HexabitzPlatform/H41R6x-Hardware/README.md

# H41R6x-Hardware
Hexabitz STM32F4 LQFP100 Module Hardware Design
