HexabitzPlatform/H41R6x-Hardware/H41R60/Released/BOM/H41R60.xlsx

Qty | Comment | Designator | Description | MFN | MPN | OCTOPART_URL | Qty
8 | 100nF | C3, C4, C5, C6, C7, C8, C10, C11 | CAP CER 10% X7R 0603 | KEMET | C0603C104K8RACTU | https://octopart.com/c0603c104k8ractu-kemet-145075?r=sp&s=9bS9ASSwSEqMCE9KBEQZ0g
1 | 1.00uF | C2 | CAP CER 1UF 16V X7R 0805 | Yageo | CC0805KKX7R7BB105 | https://octopart.com/cc0805kkx7r7bb105-yageo-8376555?r=sp&s=YKl1wwtkROau_X5nniH2ig
1 | 4.7uF | C9 | CAP CER 4.7UF 25V X6S 0805 | Murata | GRM21BC81E475KA12L | https://octopart.com/grm21bc81e475ka12l-murata-10331911?r=sp&s=RY3qZSD8T6mG6TC9CHI5qQ
2 | 2.2uF | C12, C13 | CAP CER 2.2UF 10% X7R 0603 | TDK | C1608X5R1C225K080AB | https://octopart.com/c1608x5r1c225k080ab-tdk-26013481?r=sp&s=zh0P7eqWSJSPxGSwstsLZg
1 | 10nF | C1 | CAP CER 10% X7R 0603 | KEMET | C0603C103K5RACTU | https://octopart.com/c0603c103k5ractu-kemet-133094?r=sp&s=R_iPBxLnSmGqhkU2rIMFpg
1 | VLMS1300-GS08 | D1 | Red 0603 130ｰ Clear 54 mcd 2 V Surface Mount ChipLED ; | Vishay | VLMS1300-GS08 | https://octopart.com/vlms1300-gs08-vishay-21709201?r=sp&s=_gcP4_q8T1SC6PJQPTQ9yA
1 | FB-TDK_MMZ1608Y300B | FB1 | Ferrite Beads Multi-Layer 30Ohm 25% 100MHz 1.5A 50mOhm DCR 0603 | TDK | MMZ1608Y300B | https://octopart.com/mmz1608y300b-tdk-368280?r=sp&s=cd9_2ZEqQ9q9UNBuQgHAiA
1 | 270.0R | R1 | Thick Film Resistors - SMD 0603 | Yageo | RC0603FR-07270RL | https://octopart.com/erj-3geyj271v-panasonic-55560546
1 | 0.0R | R2 | Thick Film Resistors - SMD 0603 | Yageo | RC0603JR-070RL | https://octopart.com/crcw06030000z0eahp-vishay-44320230
1 | 10.0K | R3 | Thick Film Resistors - SMD 0603 | Yageo | RC0603JR-0710KL | https://octopart.com/crcw060310k0jneb-vishay+dale-46603268
1 | STM32F413VHT6 | U1 | ARM Cortex-M4 STM32F4 Microcontroller IC 32-Bit 100MHz 1.5MB (1.5M x 8) FLASH 100-LQFP (14x14) | STMicroelectronics | STM32F413VHT6 | https://octopart.com/stm32f413vht6-stmicroelectronics-75832293?r=sp&s=_e4TXIFmR5mlyuiVVXP48A
1 | XTALL_CSTCE8M00G52 | X1 | MURATA CSTCE8M00G52-R0 RESONATOR, SMD, 8MHZ ; | Murata | CSTCE8M00G52Z-R0 | https://octopart.com/cstce8m00g52z-r0-murata-17755941?r=sp&s=JDnNJnrHQhyS8Zk4ofFWXw
