HexabitzPlatform/H41R6x-Hardware/H41R60/Documentation/H41R60-13 Schematics.pdf

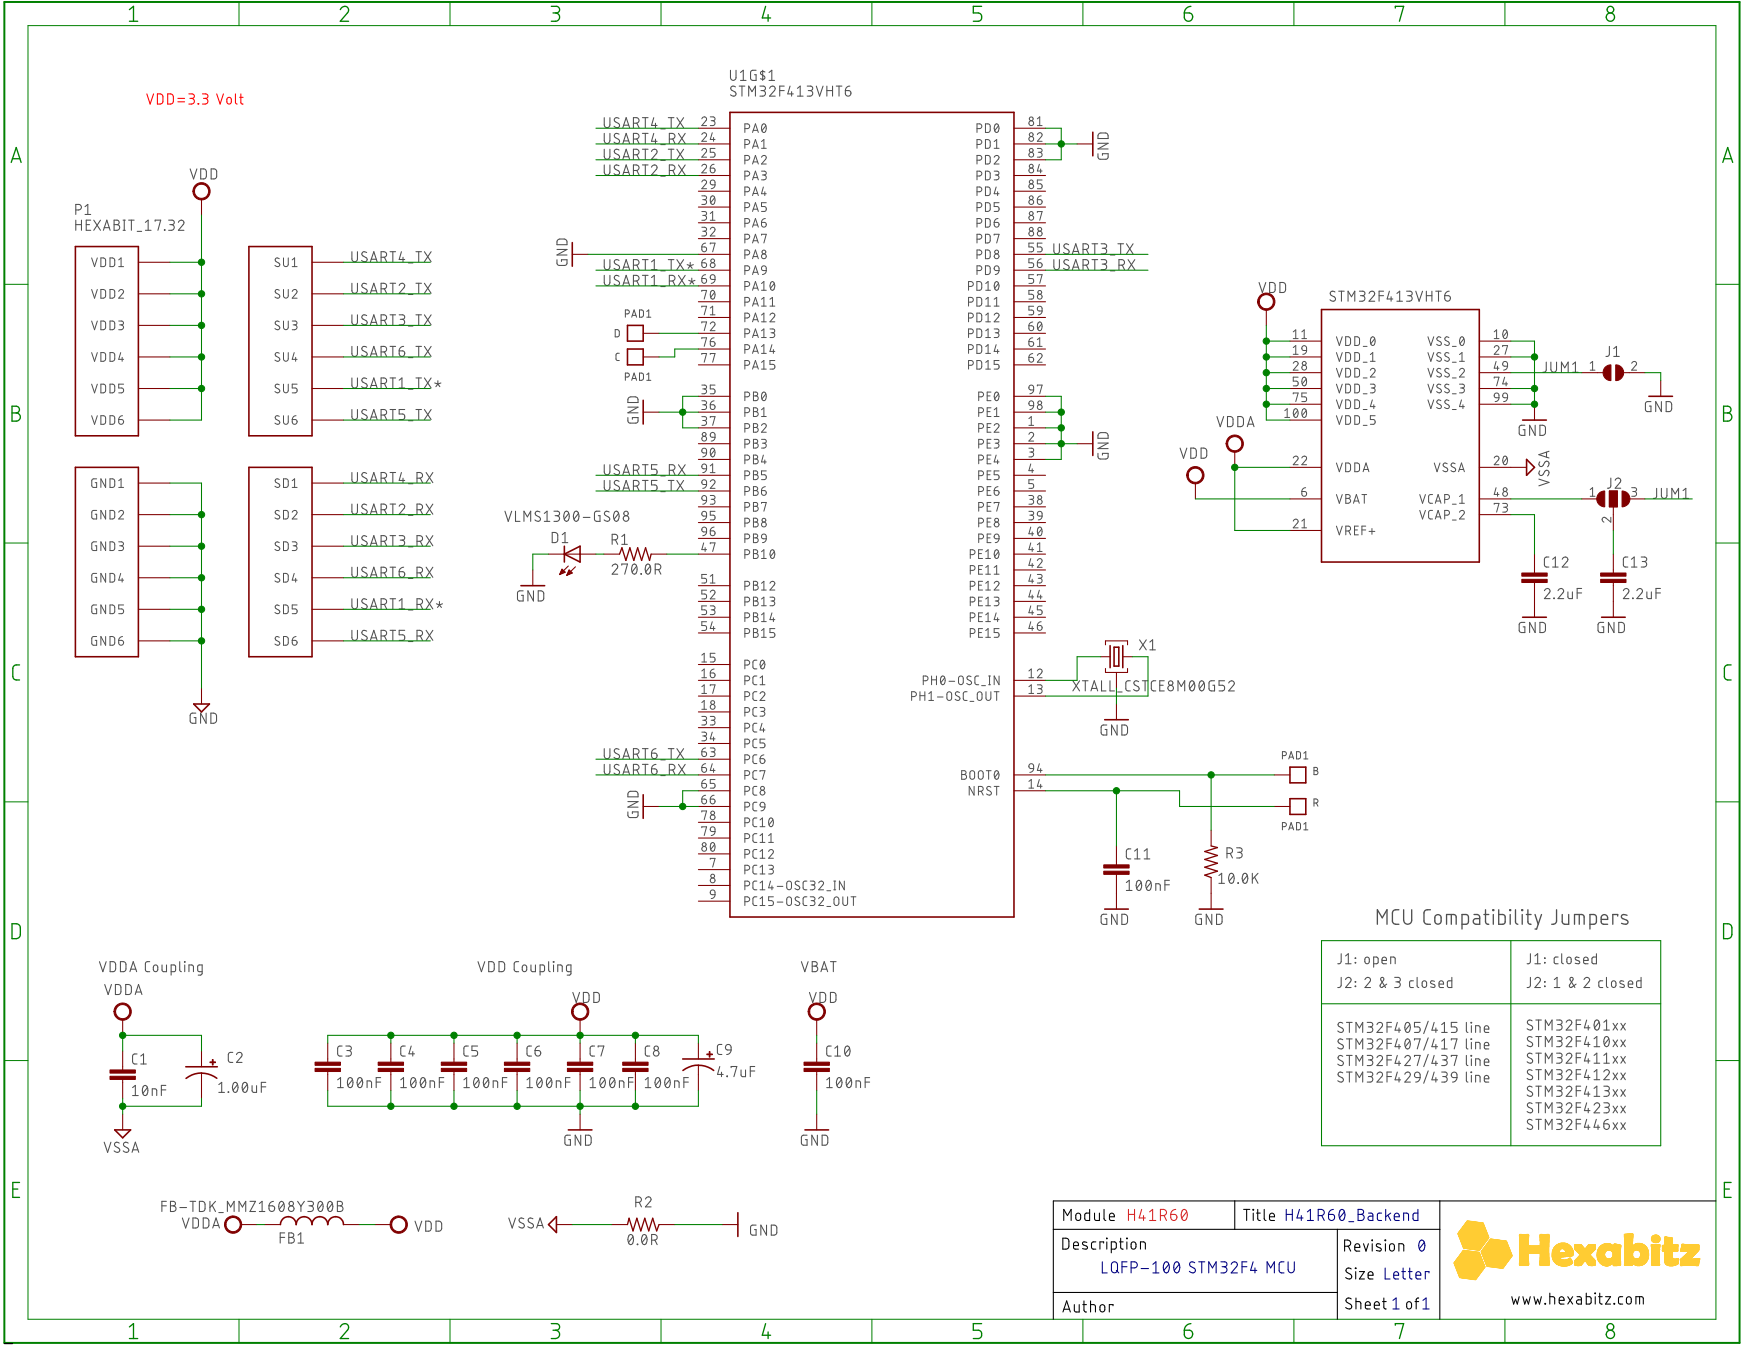
[picture p1: page 1]
