HexabitzPlatform/H41R6x-Hardware/H41R60/Design/H41R60.brd

## EAGLE design H41R60/Design/H41R60.brd (2019-05-23)

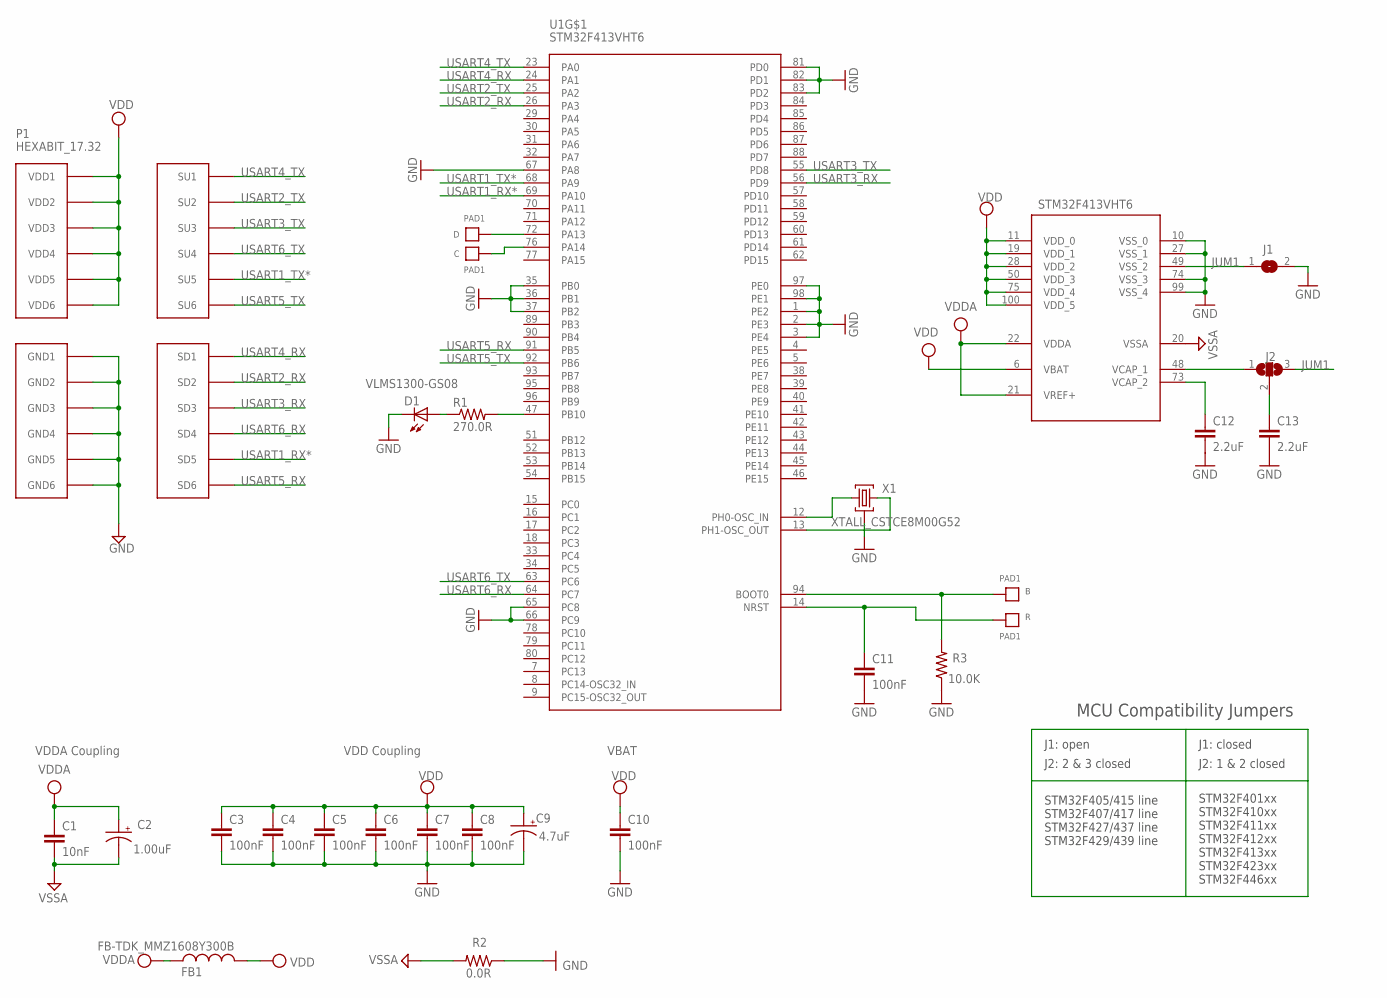
[picture p2: schematic H41R60.sch]

Parts:
B: PAD1
C: PAD1
C1: 10nF; C-0603; TOLERANCE 10%; VOLTAGE_RATING 50V; MPN C0603C103K5RACTU
C2: 1.00uF; C-0805-POL; TOLERANCE 10%; VOLTAGE_RATING 16V; MPN CC0805KKX7R7BB105
C3, C4, C5, C6, C8, C11: 100nF; C-0603; TOLERANCE 10%; VOLTAGE_RATING 10V; MPN C0603C104K8RACTU
C7: 100nF; C-0603; TOLERANCE 10%; VOLTAGE_RATING 10; MPN C0603C104K8RACTU
C9: 4.7uF; C-0805-POL; TOLERANCE 10%; VOLTAGE_RATING 25V; MPN GRM21BC81E475KA12L
C10: 100nF; C-0603; TOLERANCE 10V; VOLTAGE_RATING 10%; MPN C0603C104K8RACTU
C12, C13: 2.2uF; C-0603; TOLERANCE 16V; VOLTAGE_RATING 20%; MPN C1608X5R1C225K080AB
D: PAD1
D1: VLMS1300-GS08; MPN VLMS1300-GS08
FB1: FB-TDK_MMZ1608Y300B; MPN MMZ1608Y300B
J1: SJ
J2: SJ2W; SJ_2
P1: HEXABIT_17.32
R: PAD1
R1: 270.0R; R-0603; TOLERANCE 1%; MPN RC0603FR-07270RL
R2: 0.0R; R-0603; MPN RC0603JR-070RL
R3: 10.0K; R-0603; TOLERANCE 5%; MPN RC0603JR-0710KL
U1: STM32F413VHT6; LQFP-100
X1: XTALL_CSTCE8M00G52

Connections:
B1: B.P$1, B.P$2, R3.2, U1.94 (BOOT0)
GND: C3.2, C4.2, C5.2, C6.2, C7.2, C8.2, C9.2 (-), C10.2, C11.2, C12.2, C13.2, D1.C, J1.2, P1.PAD_PD7 (GND1), P1.PAD_PD8 (GND2), P1.PAD_PD9 (GND3), P1.PAD_PD10 (GND4), P1.PAD_PD11 (GND5), P1.PAD_PD12 (GND6), R2.1, R3.1, U1.1 (PE2), U1.2 (PE3), U1.3 (PE4), U1.10 (VSS_0), U1.27 (VSS_1), U1.35 (PB0), U1.36 (PB1), U1.37 (PB2), U1.65 (PC8), U1.66 (PC9), U1.67 (PA8), U1.74 (VSS_3), U1.81 (PD0), U1.82 (PD1), U1.83 (PD2), U1.97 (PE0), U1.98 (PE1), U1.99 (VSS_4), X1.P$2 (2)
JUM1: J1.1, J2.3, U1.49 (VSS_2)
unnamed: D.P$1, D.P$2, U1.72 (PA13)
unnamed: C.P$1, C.P$2, U1.76 (PA14)
unnamed: U1.12 (PH0-OSC_IN), X1.P$1 (1)
unnamed: U1.13 (PH1-OSC_OUT), X1.P$3 (3)
unnamed: C12.1, U1.73 (VCAP_2)
unnamed: C13.1, J2.2
unnamed: R1.2, U1.47 (PB10)
unnamed: D1.A, R1.1
unnamed: J2.1, U1.48 (VCAP_1)
R1: C11.1, R.P$1, R.P$2, U1.14 (NRST)
USART1_RX*: P1.PAD_PD5 (SD5), U1.69 (PA10)
USART1_TX*: P1.PAD_PU5 (SU5), U1.68 (PA9)
USART2_RX: P1.PAD_PD2 (SD2), U1.26 (PA3)
USART2_TX: P1.PAD_PU2 (SU2), U1.25 (PA2)
USART3_RX: P1.PAD_PD3 (SD3), U1.56 (PD9)
USART3_TX: P1.PAD_PU3 (SU3), U1.55 (PD8)
USART4_RX: P1.PAD_PD1 (SD1), U1.24 (PA1)
USART4_TX: P1.PAD_PU1 (SU1), U1.23 (PA0)
USART5_RX: P1.PAD_PD6 (SD6), U1.91 (PB5)
USART5_TX: P1.PAD_PU6 (SU6), U1.92 (PB6)
USART6_RX: P1.PAD_PD4 (SD4), U1.64 (PC7)
USART6_TX: P1.PAD_PU4 (SU4), U1.63 (PC6)
VDD: C3.1, C4.1, C5.1, C6.1, C7.1, C8.1, C9.1 (+), C10.1, FB1.2, P1.PAD_PU7 (VDD1), P1.PAD_PU8 (VDD2), P1.PAD_PU9 (VDD3), P1.PAD_PU10 (VDD4), P1.PAD_PU11 (VDD5), P1.PAD_PU12 (VDD6), U1.6 (VBAT), U1.11 (VDD_0), U1.19 (VDD_1), U1.28 (VDD_2), U1.50 (VDD_3), U1.75 (VDD_4), U1.100 (VDD_5)
VDDA: C1.1, C2.1 (+), FB1.1, U1.21 (VREF+), U1.22 (VDDA)
VSSA: C1.2, C2.2 (-), R2.2, U1.20 (VSSA)

Notes on the sheet:
VDDA Coupling
VDD Coupling
VBAT
STM32F405/415 line STM32F407/417 line STM32F427/437 line STM32F429/439 line
STM32F401xx STM32F410xx STM32F411xx STM32F412xx STM32F413xx STM32F423xx STM32F446xx
J1: open
J2: 2 & 3 closed
J1: closed
J2: 1 & 2 closed
MCU Compatibility Jumpers
STM32F413VHT6

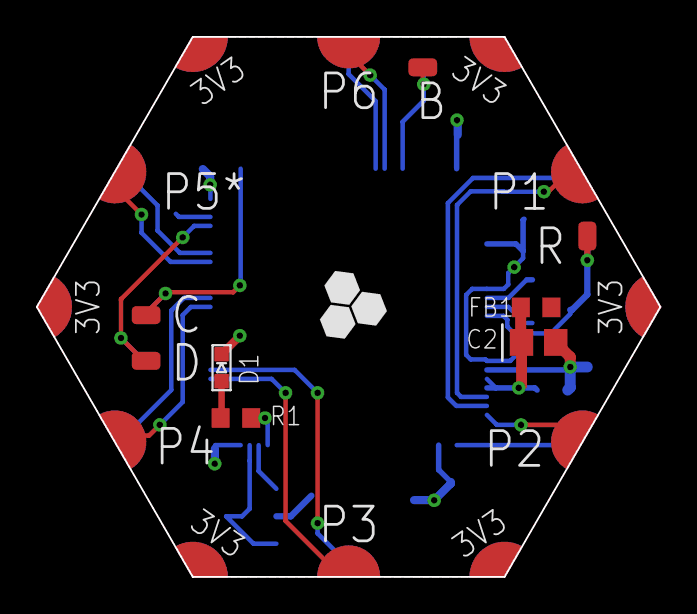
[picture p3: board H41R60.brd from above]

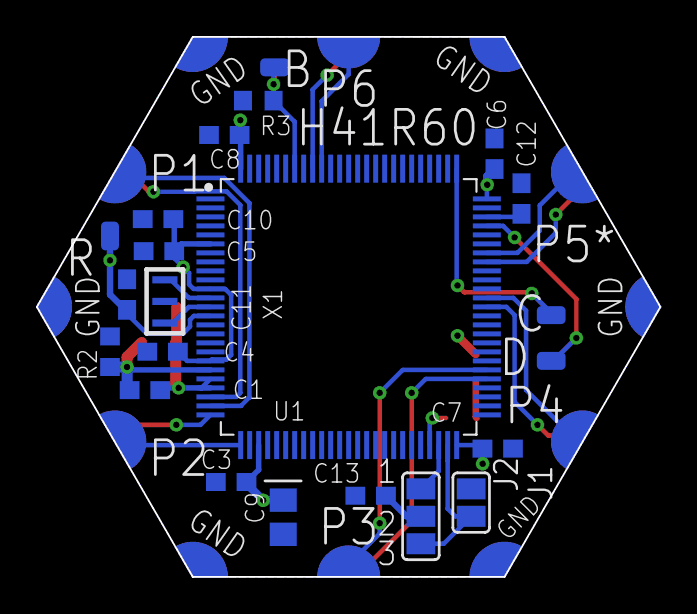
[picture p4: board H41R60.brd from below]

Board: 2 copper layers, 34.6 x 30.0 mm, 27 parts (18 on the bottom side), 28 nets.
