HexabitzPlatform/H41R6x-Hardware/(commit log)

2019-05-23 First release rev 0
    [H41R60.brd, H41R60.sch, H41R60.xlsx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]
2019-08-17 Updated BOM and schematics
    [H41R60.xlsx]
